claudiusmarius/Traceur-Courbes-Transistor-DFTA273/PCBDFTA273TOP.jpg

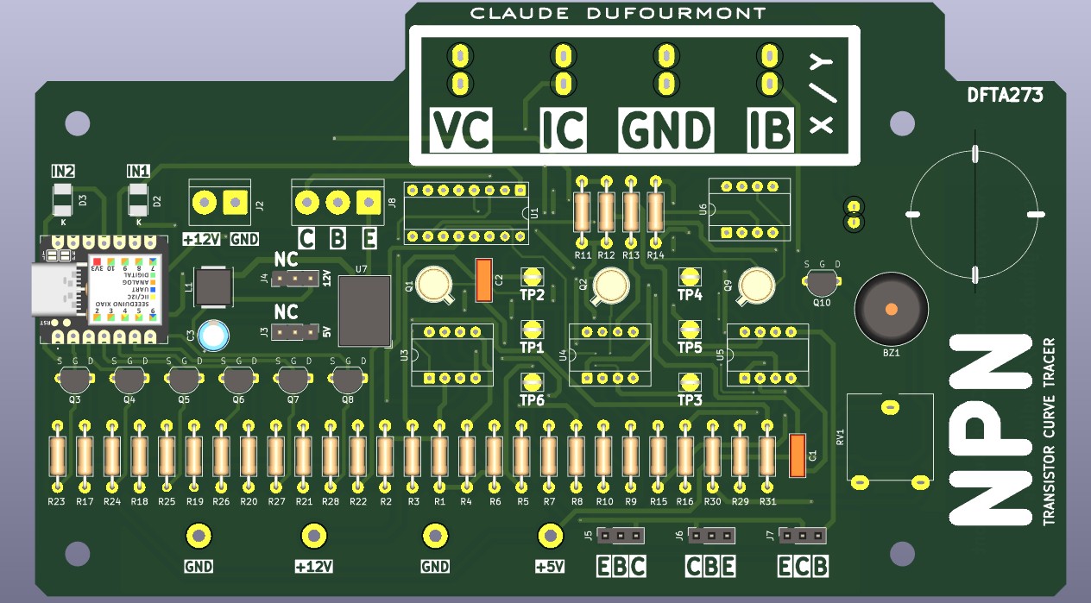
PCBDFTA273TOP.jpg
