claudiusmarius/Traceur-Courbes-Transistor-DFTA273/PCBDFTABOTTOM.jpg

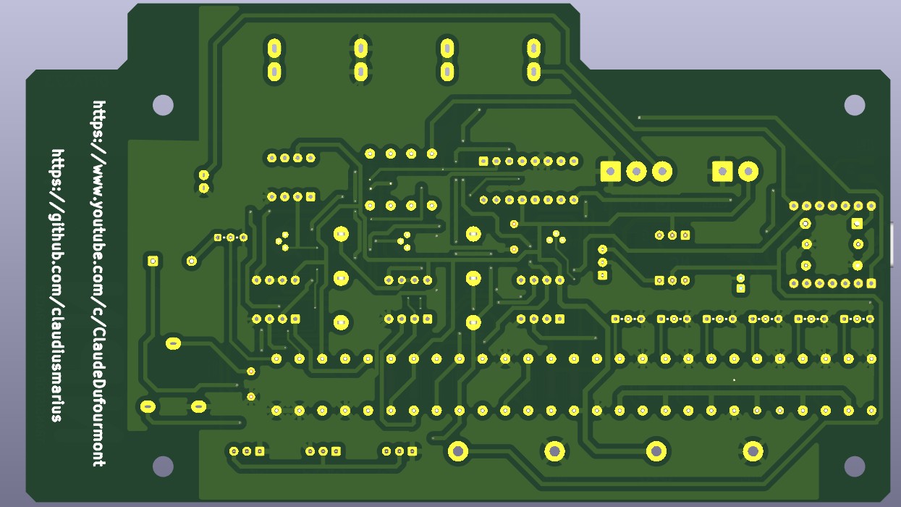
PCBDFTABOTTOM.jpg
