claudiusmarius/Traceur-Courbes-Transistor-DFTA273/README.md

# J-AI-FABRIQUE-UN-TRACEUR-DE-COURBES-POUR-TRANSISTOR-DFTA273

# DFTA273 - Traceur de courbes pour transistors

## Présentation

Le DFTA273 est un traceur de courbes destiné à la caractérisation des transistors NPN.

Le projet est basé sur un Seeeduino XIAO (SAMD21) et a été développé dans le but de réaliser un instrument de mesure simple, économique et facilement reproductible.

Deux modes de fonctionnement sont disponibles :

- IC = f(VCE) : famille de courbes de sortie.
- IC = f(IB) à VCE constante : caractéristique de transfert.

Le traceur est destiné à être utilisé avec un oscilloscope en mode X-Y.

---

## Le dépôt contient

- Schéma électronique
- Projet KiCad
- Fichiers Gerber
- Nomenclature (BOM)
- Guide d'utilisation
- Tableur de calcul
- Code source Arduino

---

## Matériel nécessaire

- Alimentation 12 V
- Oscilloscope avec mode X-Y
- Seeeduino XIAO
- Transistor à tester
- Câble USB pour la programmation

---

## État du projet

Prototype validé sur breadboard.

PCB Terminé et essais effectués

---

## Licence

Projet open source.

Vous êtes libre de l'étudier, de le modifier et de l'améliorer.

Un retour d'expérience ou une amélioration sera toujours apprécié.

Bonnes réalisations !

Claude Dufourmont
