claudiusmarius/Traceur-Courbes-Transistor-DFTA273/DFTA273TERComposants.xlsx

REF | Designation | Unité | Commentaires
BZ1 | Buzzer |  | 5V
C1 | 100 | nF
C2 | 100 | nF
C3 | 4.7 | µF | 50V
D1 | 1N5817 |  | Schottky
D2 | LED CMS |  | Rouge LST672 | Gotronic 16910
D3 | LED CMS |  | Jaune LYT670 | Gotronic 16911
J2 | Bornier à vis |  | 2 Bornes | AliExpress
J3 | Pinheader + cavalier |  | 3 pins | AliExpress
J4 | Pinheader + cavalier |  | 3 pins | AliExpress
J5 | Pin Socket |  | 3 pins | AliExpress
J6 | Pin Socket |  | 3 pins | AliExpress
J7 | Pin Socket |  | 3 pins | AliExpress
J8 | Bornier à vis |  | 3 Bornes | AliExpress
L1 | RLS-397 inductance 3,9 | µH | Recom | RS Particulier 1855864
Q1 | BJT NPN | 2N2222A | TO18 | Gotronic 02412
Q2 | BJT PNP | 2N2907A | TO18 | Gotronic 02419
Q3 | Mosfet Canl N | BS170 |  | RS Particulier 6714736
Q4 | Mosfet Canl N | BS170 |  | RS Particulier 6714736
Q5 | Mosfet Canl N | BS170 |  | RS Particulier 6714736
Q6 | Mosfet Canl N | BS170 |  | RS Particulier 6714736
Q7 | Mosfet Canl N | BS170 |  | RS Particulier 6714736
Q8 | Mosfet Canl N | BS170 |  | RS Particulier 6714736
Q9 | BJT NPN | 2N2222A | TO18 | Gotronic 02412
Q10 | Mosfet Canl N | BS170 |  | RS Particulier 6714736
R1 | 820 | Ω |  | Gotronic 04099
R2 | 1 | K |  | Gotronic 04099
R3 | 220 | Ω | au lieu de 10 | Gotronic 04099
R4 | 10 | K |  | Gotronic 04099
R5 | 10 | Ω |  | Gotronic 04099
R6 | 100 | K |  | Gotronic 04099
R7 | 10 | K |  | Gotronic 04099
R8 | 100 | K |  | Gotronic 04099
R9 | 12 | K |  | Gotronic 04099
R10 | 4.7 | K |  | Gotronic 04099
R11 | 1 | K |  | Gotronic 04099
R12 | 1 | K |  | Gotronic 04099
R13 | 4.7 | K |  | Gotronic 04099
R14 | 4.7 | K |  | Gotronic 04099
R15 | 100 | K |  | Gotronic 04099
R16 | 100 | K |  | Gotronic 04099
R17 | 12 | K |  | Gotronic 04099
R18 | 22 | k |  | Gotronic 04099
R19 | 39 | k |  | Gotronic 04099
R20 | 82 | K |  | Gotronic 04099
R21 | 220 | K |  | Gotronic 04099
R22 | 470 | K |  | Gotronic 04099
R23 | 56 | K |  | Gotronic 04099
R24 | 56 | K |  | Gotronic 04099
R25 | 56 | K |  | Gotronic 04099
R26 | 56 | K |  | Gotronic 04099
R27 | 56 | K |  | Gotronic 04099
R28 | 56 | K |  | Gotronic 04099
R29 | 3.9 | K |  | Gotronic 04099
R30 | 27 | K |  | Gotronic 04099
R31 | 56 | K |  | Gotronic 04099
R32 | 820 | Ω |  | Gotronic 04099
R33 | 820 | Ω |  | Gotronic 04099
RV1 | 10 | K |  | Gotronic 04099
TP1 | Cosse poignard |  |  | Gotronic 08312
TP2 | Cosse poignard |  |  | Gotronic 08312
TP3 | Cosse poignard |  |  | Gotronic 08312
TP4 | Cosse poignard |  |  | Gotronic 08312
TP5 | Cosse poignard |  |  | Gotronic 08312
TP6 | Cosse poignard |  |  | Gotronic 08312
U1 | ADG486 | DIP | + Socket 16 pins | AliExpress
 |  |  | KXHD1688 Store
U2 | Seeeduino XIAO |  | + 2 pin sockets 7 pins | Rs Particulier 6612066
U3 | TLV2372 |  | + Socket 8 pins | Rs Particulier 6612066
U4 | TLV2372 |  | + Socket 8 pins | Rs Particulier 6612066
U5 | TLV2372 |  | + Socket 8 pins | Rs Particulier 6612066
U6 | LT1006 |  | + Socket 8 pins | AliExpress
U7 | R-78E5.0-0.5 |  | Switching regulator RECOM 5V 500mA | RS Particulier 7577239
 | RP-C18-ST |  | BP H13 et H14 | AliExpress
 | Cosses de connection |  | Terminaux de soudure DJ610-2.8-2 | AliExpress
 |  |  | Boutique officielle dojioxcn
 |  |  | Nº de la boutique: | 911031056
 | Supports TO18 |  | Réhausseurs entretoise | Récupération
