claudiusmarius/Traceur-Courbes-Transistor-DFTA273/Calculette273.xlsx

Sheet: IB IC VCE
DONNEES D'ENTREE |  |  |  |  |  |  |  | DDFTA273
VCC | 12 | V |  |  | Sortie DAC MAX | 3.3 | V
R10 | 4.7 | KΩ |  |  | R1 | 0.82 | KΩ
R9 | 12 | KΩ |  |  | R2 | 1 | KΩ
R29 | 3.9 | KΩ
VBEQTEST | 0.65 | V
 |  |  | DONNEES DE SORTIE
 |  |  | Rampe VCE | 6.006 | V | MODE IC = f(VCE) |  |  |  | MODE IC = f(IB)
 |  |  | VR9 |  |  | IE Q2 |  | Puissance Q2 |  | IE Q2 |  | Puissance Q2
R17 | 12 | KΩ |  | 3.38 | V | 0.281 | mA | 2.43 | mW | 0.33 | mA | 2.66 | mW
R18 | 22 | KΩ |  | 2.11 | V | 0.176 | mA | 1.52 | mW
R19 | 39 | KΩ |  | 1.29 | V | 0.108 | mA | 0.93 | mW
R20 | 82 | KΩ |  | 0.65 | V | 0.054 | mA | 0.47 | mW
R21 | 220 | KΩ |  | 0.25 | V | 0.021 | mA | 0.18 | mW
R22 | 470 | KΩ |  | 0.12 | V | 0.010 | mA | 0.09 | mW
 |  |  |  |  |  | IE Q2 = IBQTEST |  | IMAGE IB
R11 | 1 | KΩ | ATTENTION : Toutes les valeurs figurant dans cet encart sont des valeurs calculées |  |  | 0.281 | mA | 2.994 | V |  | ON PEUT SIMPLIFIER
R12 | 1 | KΩ | Ne RIEN INTRODUIRE DANS CES CAS SINON VOUS DETRUIRIEZ LES FORMULES QUI S'Y TROUVENT |  |  | 0.176 | mA | 1.873 | V
TP3 | 0.65 | V |  |  |  | 0.108 | mA | 1.144 | V |  |  | 1V
VBQTEST | 0.60 | V |  |  |  | 0.054 | mA | 0.577 | V |  |  | =
R16 R15 | 100 | KΩ |  |  |  | 0.021 | mA | 0.223 | V |  |  | 100µA
R13 R14 | 4.7 | KΩ |  |  |  | 0.010 | mA | 0.105 | V
TP1 | 3.4 | V
TP6 | 2.8 | V |  |  |  | IC QTEST |  | VSHUNT
R5 | 10 | Ω |  |  |  | 60 | mA | 6.0 | V |  | ON PEUT DIRE
R6 R8 | 100 | KΩ
R4 R7 | 10 | KΩ |  |  |  | Une seule case pour IC car c'est un parmètre dépendant du chaque transistor, ici la formule donne une valeur en fonction des mesures "effectuées" sur TP1 et TP6 |  |  |  |  |  | 1V
 |  |  |  |  |  |  |  |  |  |  |  | =
Les données dans les cases vertes foncées encadrées de rouge sont des données hypothétiques pour simuler |  |  |  |  |  | En fait ces mesure ne peuvent êffectuées car les autres paramètres sont évolutifs en permanence |  |  |  |  |  | 10mA
Les autres données dans les cases vertes plu claires sont les données issues du tableau des composants |  |  |  |  |  | Il faut donc introduire des valeurs en manu por TP1 et TP6

Sheet: Conversions
R11 | 1 | KΩ | IB | 0.10 | mA
R12 | 1 | KΩ | Image IB | 2.13 | V | ON PEUT PRENDRE 1V pour 0,5mA
TP3 | 0.65 | V
VBQTEST | 0.6 | V | IC | 60 | mA
R16 R15 | 100 | KΩ | VSHUNT | 6 | V | ON PEUT PRENDRE 1V pour 10mA
R13 R14 | 4.7 | KΩ
TP1 | 3.4 | V
TP6 | 2.8 | V
R5 | 10 | Ω
R6 R8 | 100 | KΩ | Le gain en courant est donc
R4 R7 | 10 | KΩ
