claudiusmarius/Traceur-Courbes-Transistor-DFTA273/DFTA273.pdf

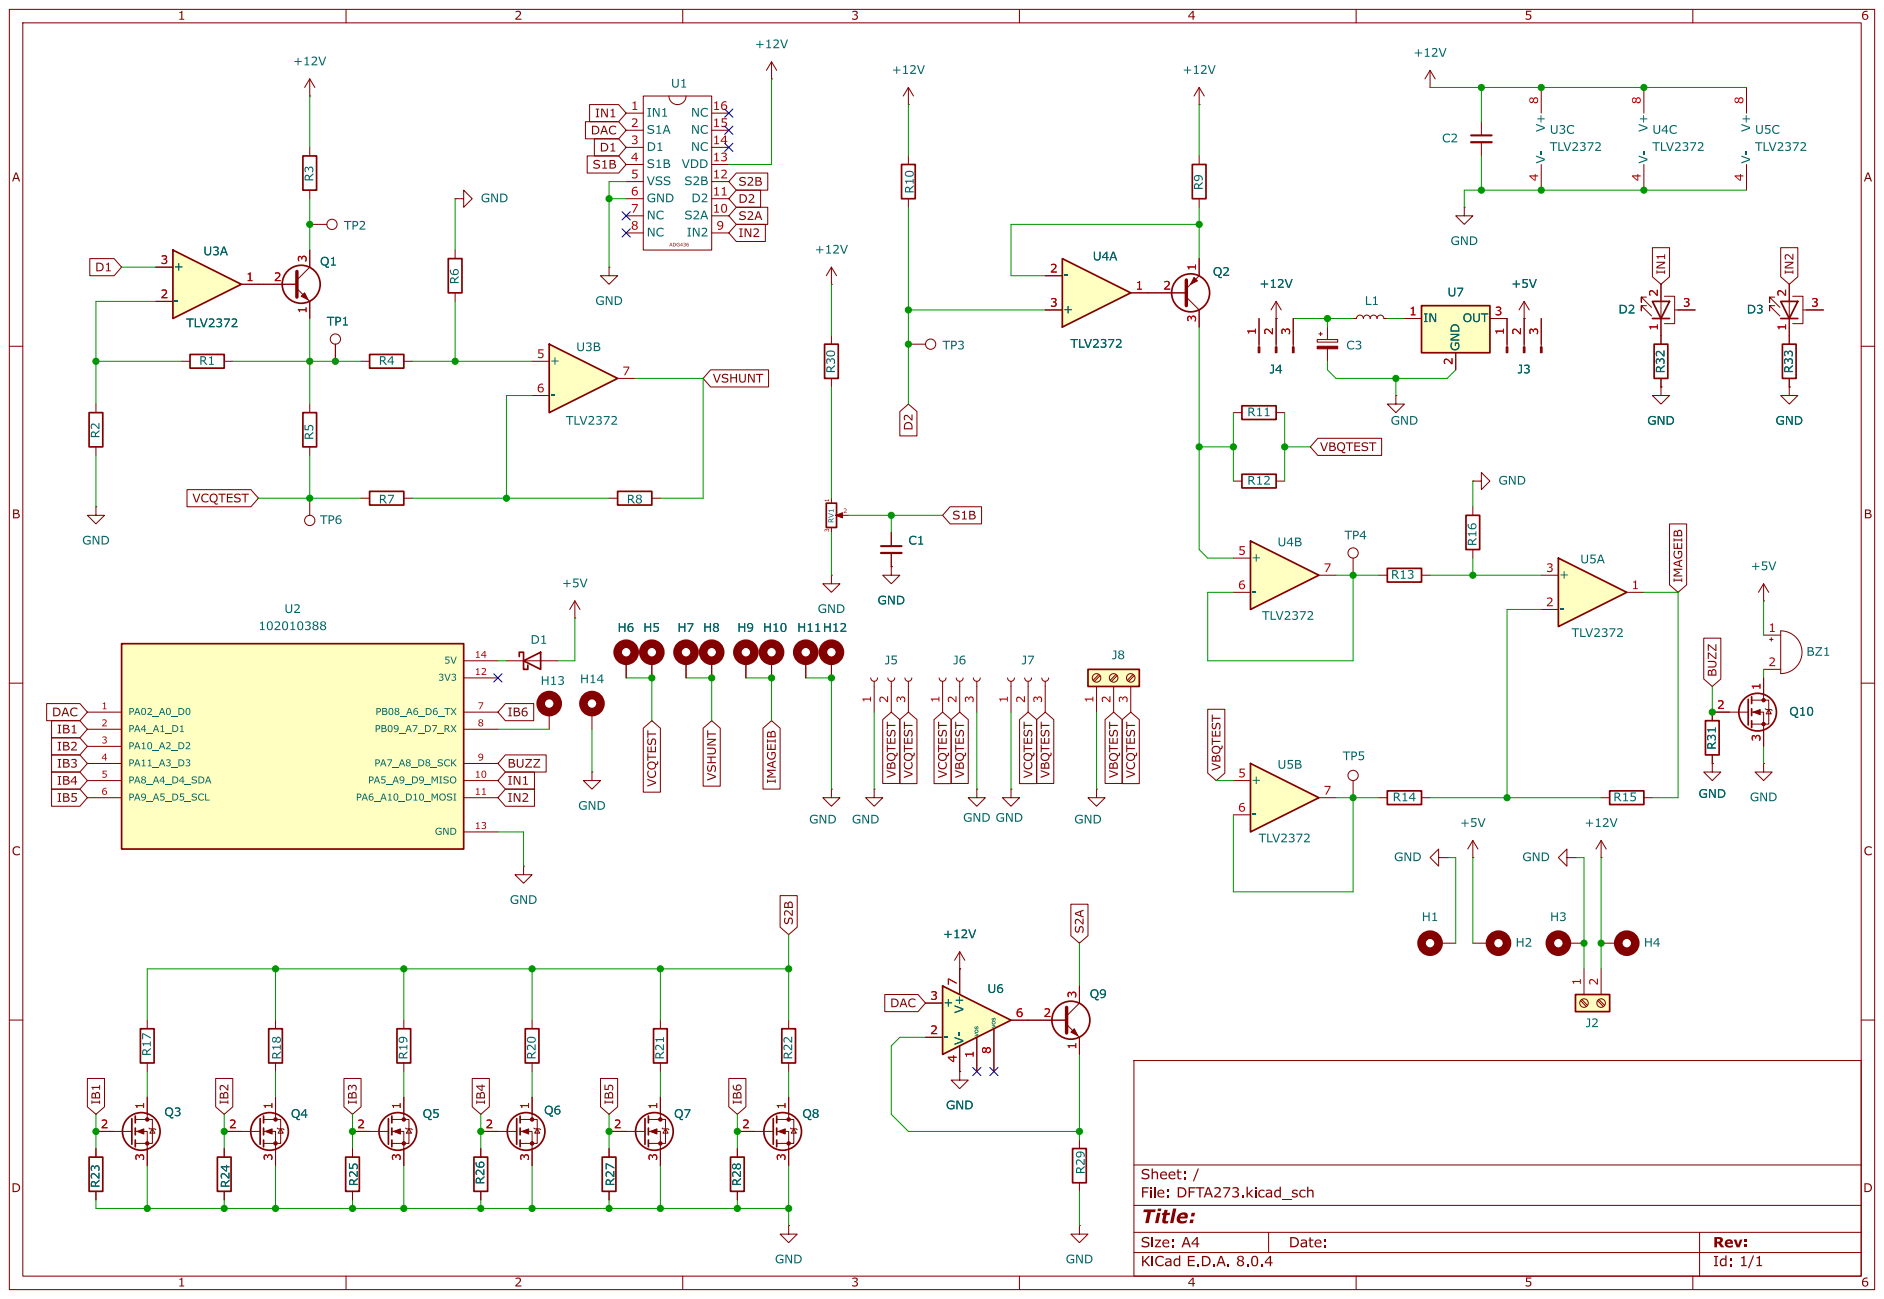
[picture p3: page 1]

Id: 1/1 Title: File: DFTA273.kicad_sch Sheet: / H10 H11GND R19
