claudiusmarius/Traceur-Courbes-Transistor-DFTA273/DFTA273LTSPICE.asc

Q1: npn; 2N2222
Q2: npn; 2N2222
Q3: pnp; 2N2907
Q4: npn; 2N2222
Q5: npn; 2N2222
R1: res; 10
R2: res; 100k
R3: res; 10k
R4: res; 100k
R5: res; 10k
R6: res; 500
R7: res; 820
R8: res; 1k
R9: res; 4.7K
R10: res; 3.9k
R11: res; 1
R12: res; 18k
R13: res; 200K
R14: res; 10k
R15: res; 200K
R16: res; 10k
R17: res; 1k
R18: res; 10k
R19: res; 1000K
R21: res; 12K
R22: res; 10
U1: UniversalOpAmp2
U2: UniversalOpAmp2
U3: LT1006
U4: LT1006
U5: LT1006
U6: UniversalOpAmp2
U7: UniversalOpAmp2
U8: ADG436
U9: ADG436
V1: voltage; 12
V2: voltage; 3
V3: voltage; 3
V4: voltage; 0
Named nets: 0, VCC1, VSHUNT, VC, V33, V3, Vcourant, VBQ1, ImageIB, Point, VR22BAS, VCQ3, VBB, V2, D1, D2, IN1, IN2, VCQ4
.dc V3 0 3 0.001
CONVERSION IB EN TENSION
NPN A TESTER
AMPLIFICATION EN TENSION ET EN COURANT
CONVERSION IC EN TENSION
ALIMENTATION AOP
GENE COURANT BASE
Tension fixe pour VCE
Rampe pour IB (DAC)
